mhdawson/arduino-sensors/(commit log)

2016-01-06 Initial versions off 433Mhz related receive functionality
    - Derived from the PI based 433MHz receive code from this
    project: https://github.com/mhdawson/PI433WirelessTXManager
    - PI433.cpp/PI433.h still need to be refactored as the name
    is no longer appropriate
    - Work in progress as I'm pulling these out of one level
    Arduino sketch and breaking it into directories such
    that mulitple sketches will re-use the common directories
2016-01-10 Initial version of arduino 2272 Device
2016-01-10 Initial version of DS18B20 sensor
2016-01-10 initial version of DHT base temp/humidity sensor
2016-01-10 initial version of Lacross141 device
2016-01-10 Fix up compile failures due to refactor
    - update include files to use TXDevice.h instead of Device.h
    [ArduinoTHSensor.h, DeviceLacross141.h]
2016-01-10 Initial version of Arduino Light sensor
    - uses simple Light Sensitive Photoresistor 5516 GL5516 NT00183
    - with a voltage devider and one of the analog pins
2016-01-10 Initial version of 2262 device used to receive 433 messages
2016-01-12 Initial DoorAndTempSensor
    - This sensor combines an open/close door sensor with
    a DS18B20 temperature sensor
    - It uses one Device2272 and one ArduinoDS18B20Sensor
    - The door state (open/close) and the temperature is sent
    once every 2 minutes of when the state of the door changes
2016-01-16 Initial versions of code to send IR message
    - on reception of 2262 message over 433, sends out IR message
    - currently being used to send messages to AC
2016-01-16 Add file with Ir codes
    These codes are for my wall mounted AC. They were recorded
    using LIRC on a Raspberry PI. More details will be included
    in the README for this device
2016-02-02 Add ArduinoTHSensor2 and DHTSensor sketch
    - add ArduinoTHSensor2 for use with DHT22 that provides higher resolution
    temperator
    - add sample sketch using ArduinoTHSensor/ArduinoTHSensor2
2016-02-06 Add pictures and schematic for ACRemote
2016-02-06 Add pictures and schematic for DoorAndTempSensor
2016-02-06 Add DHT sensor schematic
2016-02-07 Refactor into separate directory for sensor and add README.md
2016-02-07 Update ids to match my sensor
    - update ids to match my sensor to simply redeploy
    when needed
2016-02-07 Update master readme to include DHTSensor
    - update master readme to include DHTSensor in the examples
    - fix cut/paste error in DHTSensor readme
2016-02-07 Initial version of ACRemote sensor/controller
2016-03-05 Fix error in ACRemote wiring diagram
2016-03-06 Add wiring diagram for light sensor
2016-03-06 Add project for simple light sensor
    This is a subset of the ACRemote but I like to have a project for
    each of my deployed devices so that I can easily recreate the
    firmware if necessary.
2016-03-06 Fix typo in link to wiring diagram
2016-03-06 Fix up wiring diagrams
    In both LightSensor and ACRemote wiring diagrams the trasnmitter
    and receivers were labelled with the incorrect part number
2016-03-10 Remove text left over from cut and paste
2016-04-16 Fix up reliability of door sensor
    We were not receiving messages from the door sensor reliably
    Tuned some of the timing and double up on the message
    being sent when the door state changes.
    [Device2272.cpp, DoorAndTempSensor.ino]
2016-09-09 fix up diagram, switch should close to gnd.
